DarioMSW/ESP32_Board/Hardware/v1.0/ESP32S3_DevBoard.brd

## EAGLE design Hardware/v1.0/ESP32S3_DevBoard.brd (2025-02-07)

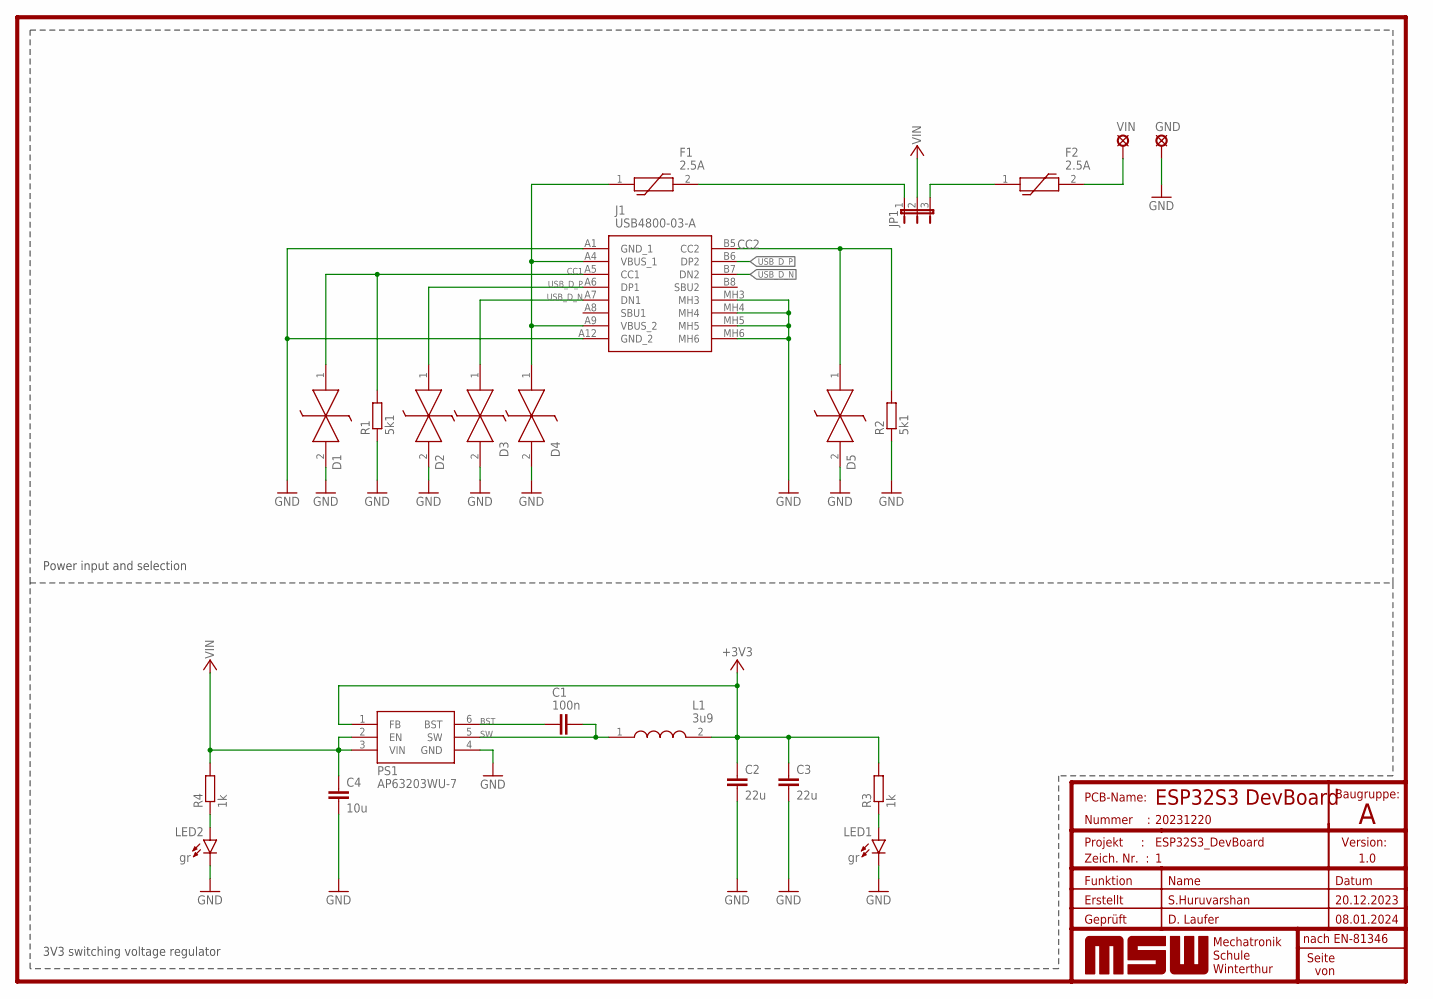
[picture p1: schematic ESP32S3_DevBoard.sch, sheet 1]

Parts:
C1: 100n; C0805
C2, C3: 22u; C1206
C4: 10u; C1206
D1, D2, D3, D4, D5: GG060305100N2P; DIONC1608X70N
F1, F2: 2.5A; 2920L030DR
GND: LSP10
J1: USB4800-03-A; USB480003A
JP1: JP2W
L1: 3u9; 74404052039
LED1, LED2: gr; CHIPLED_1206
PS1: AP63203WU-7; SOT95P280X100-6N
R1, R2: 5k1; R0805
R3, R4: 1k; R0805
VIN: LSP10

Connections:
+3V3: C2.1, C3.1, L1.2, PS1.1 (FB), R3.2; also elsewhere on the board
BST: C1.1, PS1.6 (BST)
CC1: D1.1 (K1), J1.A5 (CC1), R1.2
CC2: D5.1 (K1), J1.B5 (CC2), R2.2
GND: C2.2, C3.2, C4.2, D1.2 (K2), D2.2 (K2), D3.2 (K2), D4.2 (K2), D5.2 (K2), GND.MP, J1.A1 (GND_1), J1.A12 (GND_2), J1.MH3, J1.MH4, J1.MH5, J1.MH6, LED1.C, LED2.C, PS1.4 (GND), R1.1, R2.1; also elsewhere on the board
unnamed: F2.2, VIN.MP
unnamed: LED2.A, R4.1
unnamed: LED1.A, R3.1
unnamed: F1.2, JP1.1
unnamed: F2.1, JP1.3
SW: C1.2, L1.1, PS1.5 (SW)
USB_D_N: D3.1 (K1), J1.A7 (DN1), J1.B7 (DN2); also elsewhere on the board
USB_D_P: D2.1 (K1), J1.A6 (DP1), J1.B6 (DP2); also elsewhere on the board
VFUSE: D4.1 (K1), F1.1, J1.A4 (VBUS_1), J1.A9 (VBUS_2)
VTERMINAL: C4.1, JP1.2, PS1.2 (EN), PS1.3 (VIN), R4.2; also elsewhere on the board

Notes on the sheet:
Power input and selection
3V3 switching voltage regulator

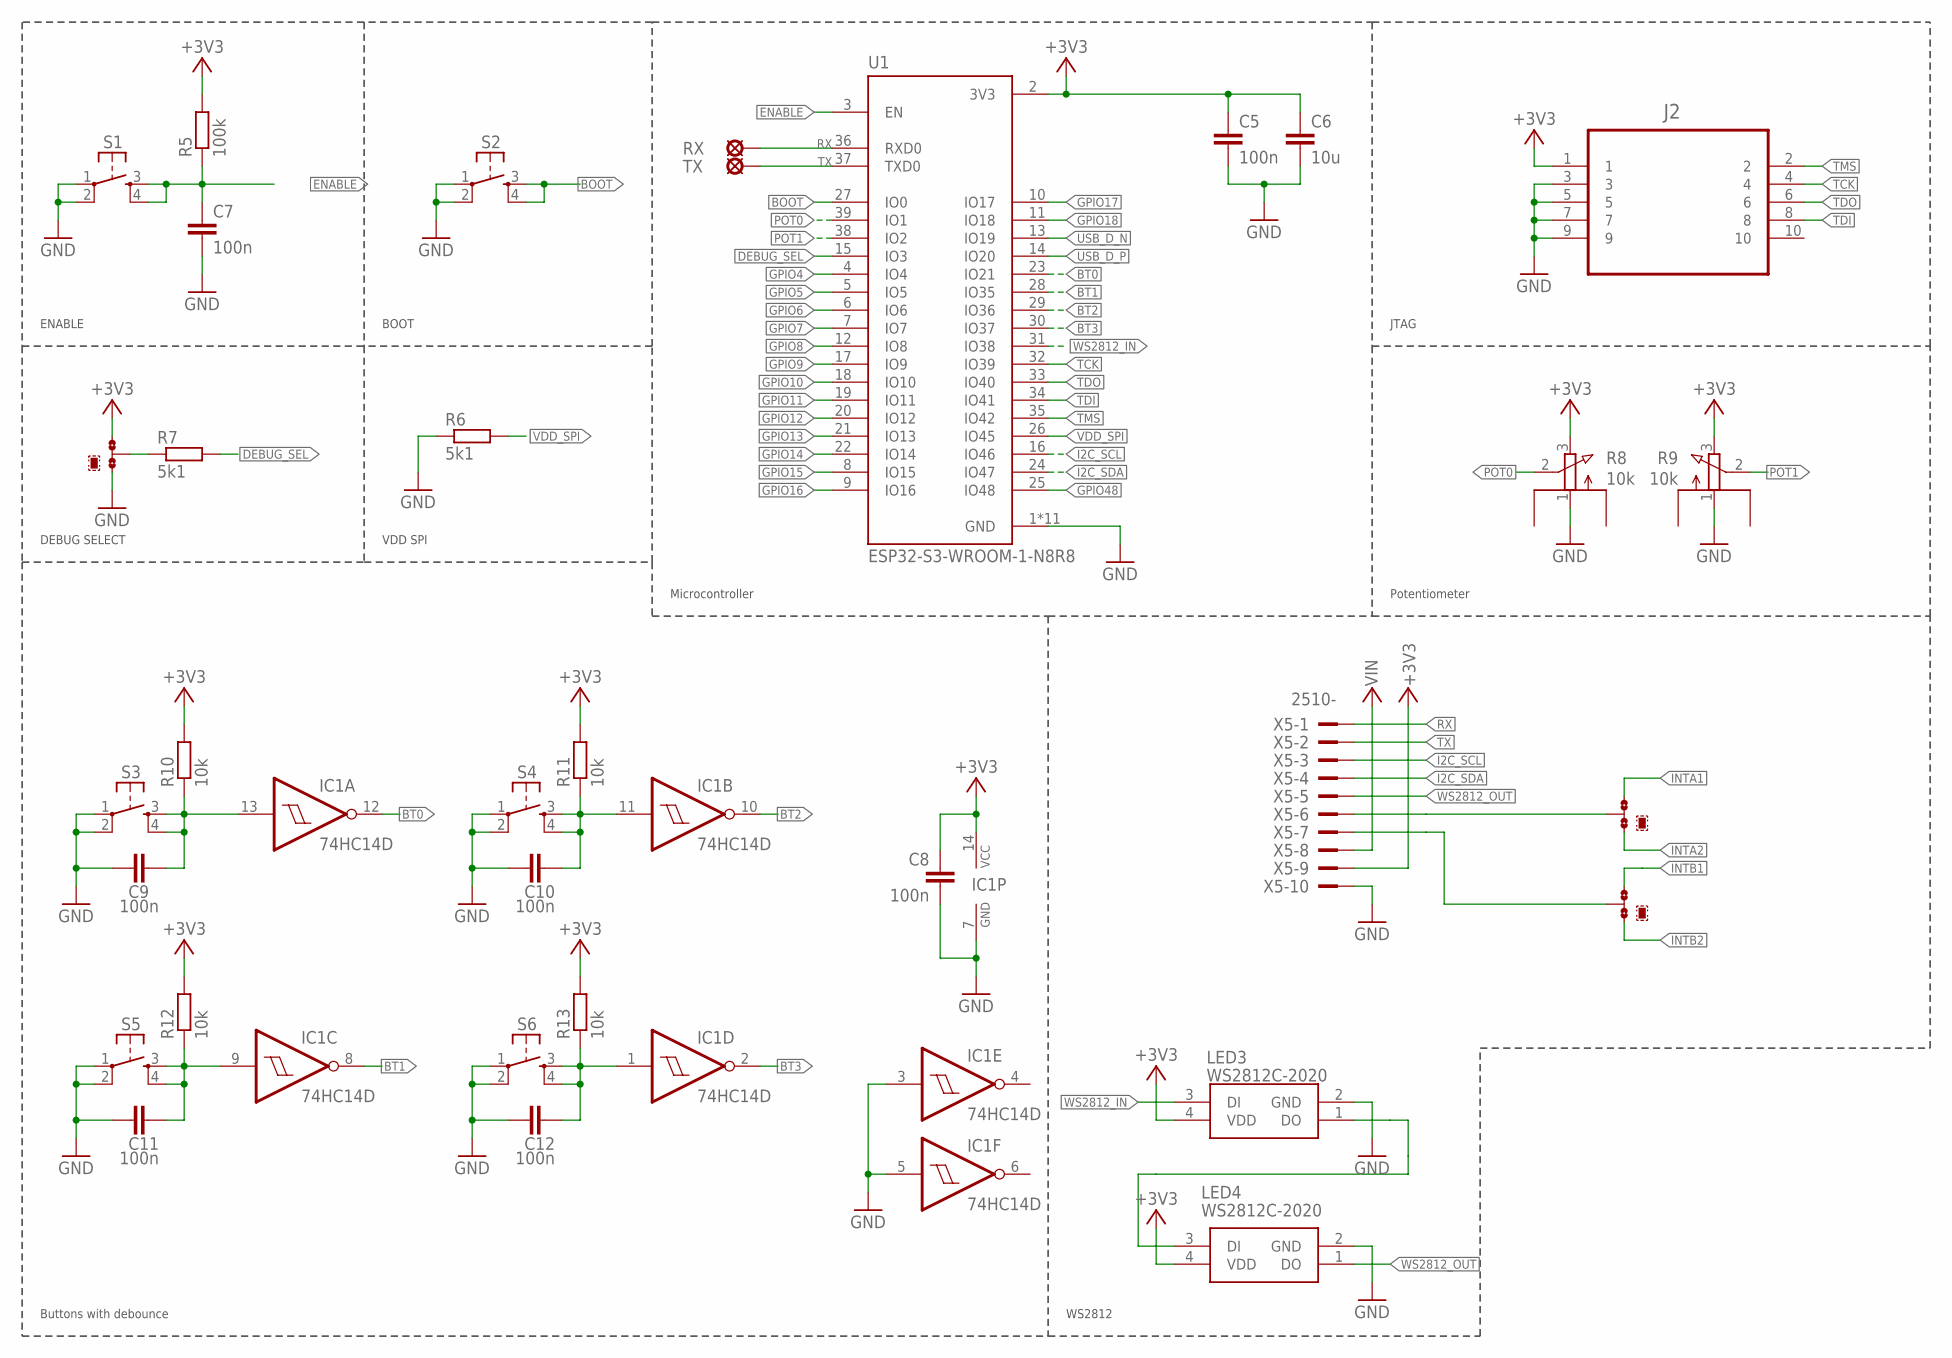
[picture p2: schematic ESP32S3_DevBoard.sch, sheet 2]

Parts:
C5, C7, C8, C9, C10, C11, C12: 100n; C0805
C6: 10u; C1206
IC1: 74HC14D; SO14
J2: 3220-10-0100-00; SAMTEC_FTS-105-01-L-D
JMP1, JMP2, JMP3: 0R-JUMPC; C0R-JMP
LED3, LED4: WS2812C-2020; WS2812C2020
R5: 100k; R0805
R6, R7: 5k1; R0805
R8, R9: 10k; EVUF
R10, R11, R12, R13: 10k; R0805
RX: LSP10
S1, S2, S3, S4, S5, S6: TS42_4PAD
TX: LSP10
U1: ESP32-S3-WROOM-1-N8R8; XCVR_ESP32S3WROOM1N8R8
X5: 2510-; PAK100/2500-10

Connections:
+3V3: C5.1, C6.1, C8.1, IC1.14 (VCC), J2.1, JMP1.1, LED3.4 (VDD), LED4.4 (VDD), R5.2, R8.3 (E), R9.3 (E), R10.2, R11.2, R12.2, R13.2, U1.2 (3V3), X5.9; also elsewhere on the board
BOOT: S2.3, S2.4, U1.27 (IO0)
BT0: IC1.12 (O), U1.23 (IO21)
BT1: IC1.8 (O), U1.28 (IO35)
BT2: IC1.10 (O), U1.29 (IO36)
BT3: IC1.2 (O), U1.30 (IO37)
DEBUG_SEL: R7.2, U1.15 (IO3)
ENABLE: C7.1, R5.1, S1.3, S1.4, U1.3 (EN)
GND: C5.2, C6.2, C7.2, C8.2, C9.2, C10.2, C11.2, C12.2, IC1.3 (I), IC1.5 (I), IC1.7 (GND), J2.3, J2.5, J2.7, J2.9, JMP1.3, LED3.2 (GND), LED4.2 (GND), R6.1, R8.1 (A), R9.1 (A), S1.1, S1.2, S2.1, S2.2, S3.1, S3.2, S4.1, S4.2, S5.1, S5.2, S6.1, S6.2, U1.1 (GND), U1.40 (GND), U1.41_1 (GND), U1.41_2 (GND), U1.41_3 (GND), U1.41_4 (GND), U1.41_5 (GND), U1.41_6 (GND), U1.41_7 (GND), U1.41_8 (GND), U1.41_9 (GND), X5.10; also elsewhere on the board
GPIO4: U1.4 (IO4); also elsewhere on the board
GPIO5: U1.5 (IO5); also elsewhere on the board
GPIO6: U1.6 (IO6); also elsewhere on the board
GPIO7: U1.7 (IO7); also elsewhere on the board
GPIO8: U1.12 (IO8); also elsewhere on the board
GPIO9: U1.17 (IO9); also elsewhere on the board
GPIO10: U1.18 (IO10); also elsewhere on the board
GPIO11: U1.19 (IO11); also elsewhere on the board
GPIO12: U1.20 (IO12); also elsewhere on the board
GPIO13: U1.21 (IO13); also elsewhere on the board
GPIO14: U1.22 (IO14); also elsewhere on the board
GPIO15: U1.8 (IO15); also elsewhere on the board
GPIO16: U1.9 (IO16); also elsewhere on the board
GPIO17: U1.10 (IO17); also elsewhere on the board
GPIO18: U1.11 (IO18); also elsewhere on the board
GPIO48: U1.25 (IO48); also elsewhere on the board
I2C_SCL: U1.16 (IO46), X5.3; also elsewhere on the board
I2C_SDA: U1.24 (IO47), X5.4; also elsewhere on the board
INTA1: JMP2.3; also elsewhere on the board
INTA2: JMP2.1; also elsewhere on the board
INTB1: JMP3.3; also elsewhere on the board
INTB2: JMP3.1; also elsewhere on the board
unnamed: JMP1.2, R7.1
unnamed: C9.1, IC1.13 (I), R10.1, S3.3, S3.4
unnamed: C11.1, IC1.9 (I), R12.1, S5.3, S5.4
unnamed: C10.1, IC1.11 (I), R11.1, S4.3, S4.4
unnamed: C12.1, IC1.1 (I), R13.1, S6.3, S6.4
unnamed: LED3.1 (DO), LED4.3 (DI)
unnamed: JMP2.2, X5.6
unnamed: JMP3.2, X5.7
POT0: R8.2 (S), U1.39 (IO1)
POT1: R9.2 (S), U1.38 (IO2)
RX: RX.MP, U1.36 (RXD0), X5.1
TCK: J2.4, U1.32 (IO39)
TDI: J2.8, U1.34 (IO41)
TDO: J2.6, U1.33 (IO40)
TMS: J2.2, U1.35 (IO42)
TX: TX.MP, U1.37 (TXD0), X5.2
USB_D_N: U1.13 (IO19); also elsewhere on the board
USB_D_P: U1.14 (IO20); also elsewhere on the board
VDD_SPI: R6.2, U1.26 (IO45)
VTERMINAL: X5.8; also elsewhere on the board
WS2812_IN: LED3.3 (DI), U1.31 (IO38)
WS2812_OUT: LED4.1 (DO), X5.5

Notes on the sheet:
ENABLE
DEBUG SELECT
BOOT
VDD SPI
Microcontroller
JTAG
Potentiometer
Buttons with debounce
WS2812

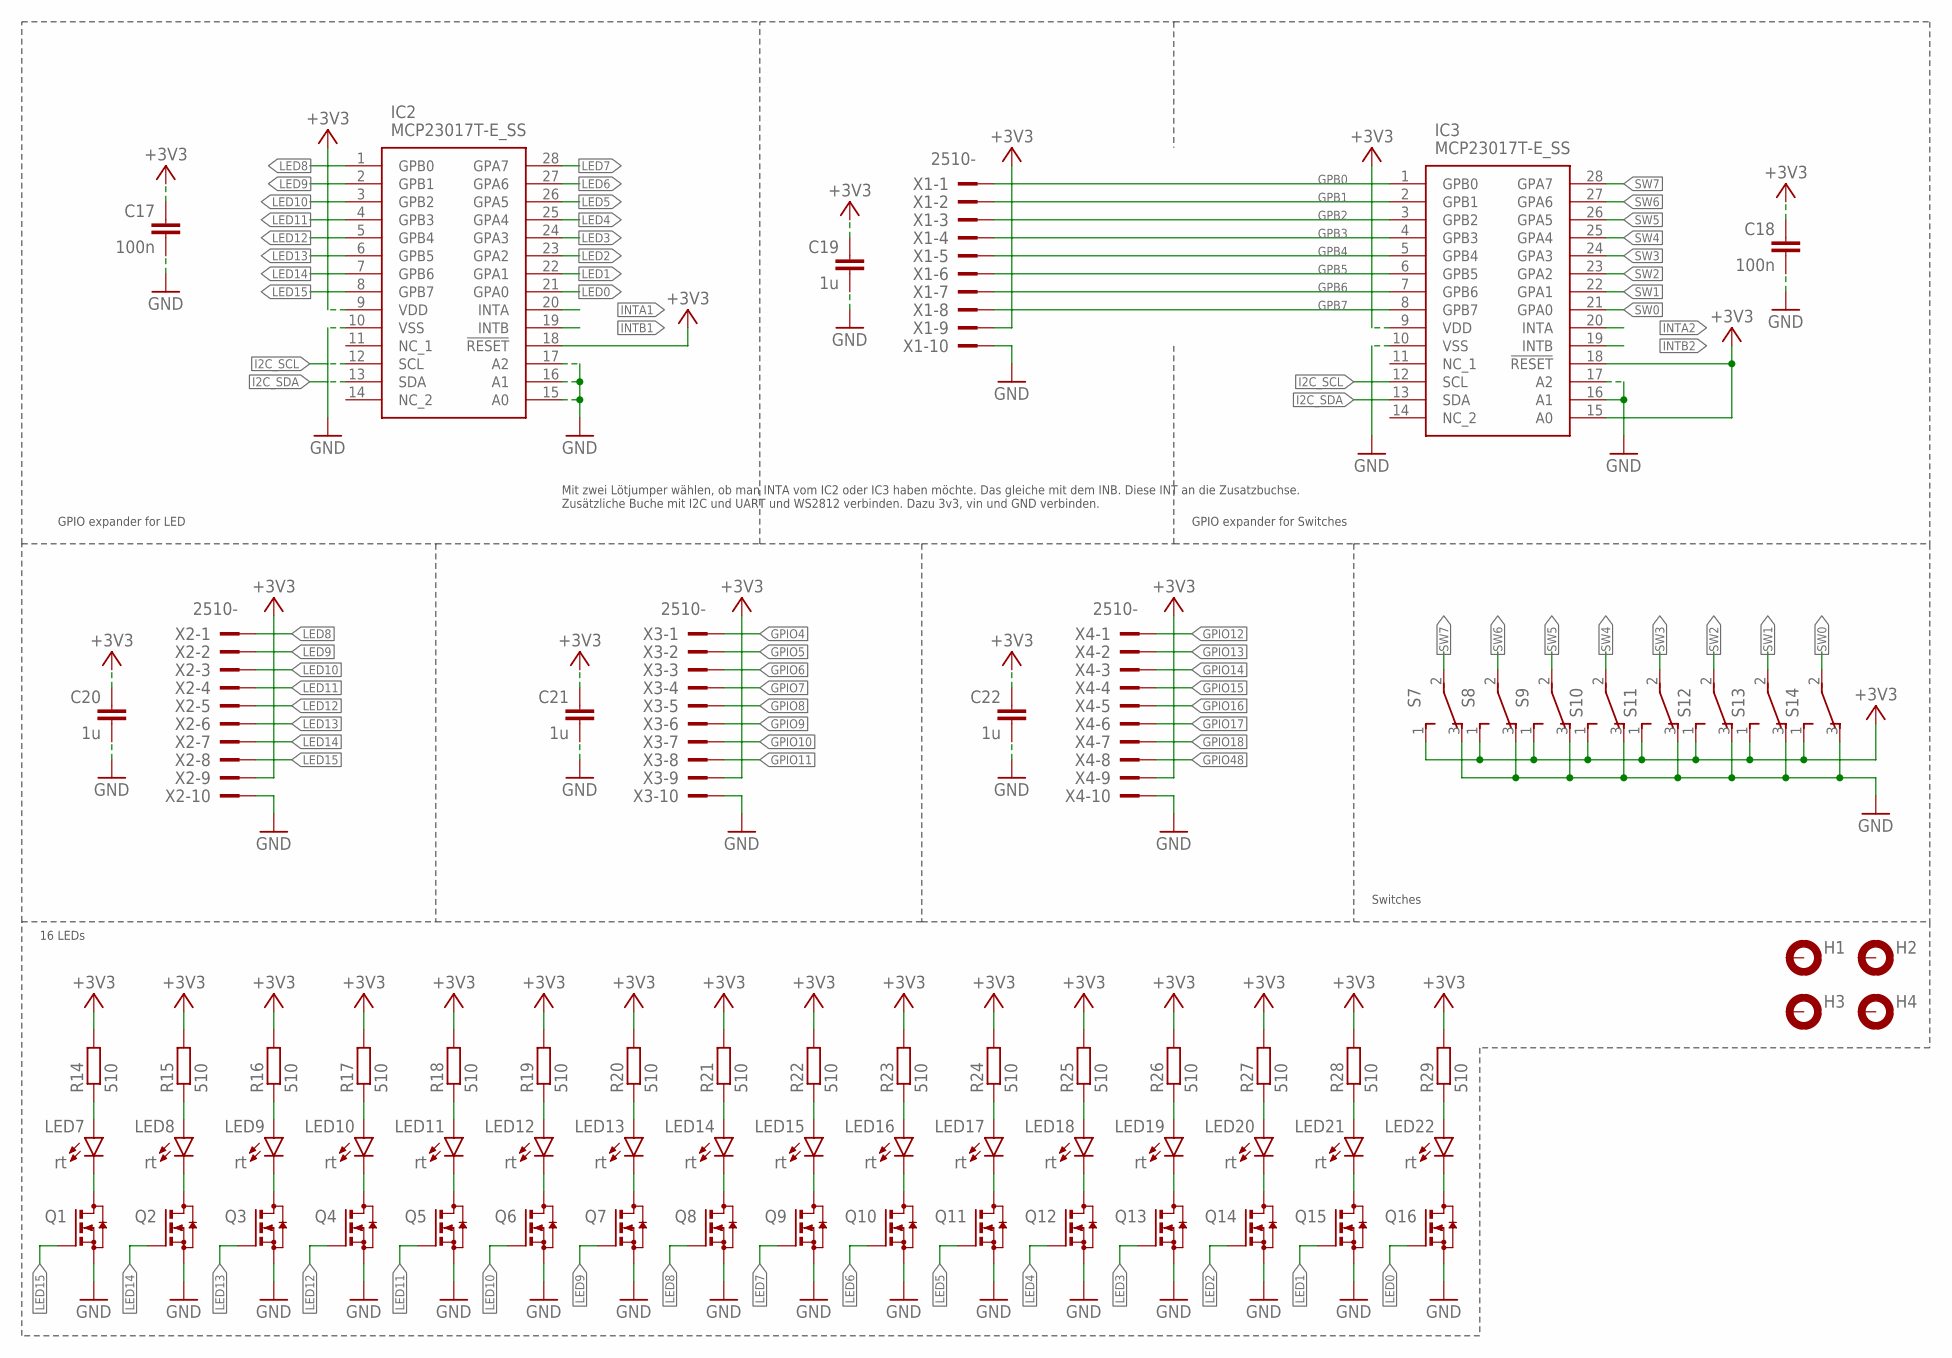
[picture p3: schematic ESP32S3_DevBoard.sch, sheet 3]

Parts:
C17, C18: 100n; C0805
C19, C20, C21, C22: 1u; C0805
H1, H2, H3, H4: MOUNT-PAD-ROUND3.3; 3,3-PAD
IC2, IC3: MCP23017T-E_SS; SOP65P780X200-28N
LED7, LED8, LED9, LED10, LED11, LED12, LED13, LED14, LED15, LED16, LED17, LED18, LED19, LED20, LED21, LED22: rt; CHIPLED_1206
Q1, Q2, Q3, Q4, Q5, Q6, Q7, Q8, Q9, Q10, Q11, Q12, Q13, Q14, Q15, Q16: PMV20EN; SOT23
R14, R15, R16, R17, R18, R19, R20, R21, R22, R23, R24, R25, R26, R27, R28, R29: 510; R0805
S7, S8, S9, S10, S11, S12, S13, S14: TL36POSPDT_5MM; SPDT_5MM
X1, X2, X3, X4: 2510-; PAK100/2500-10

Connections:
+3V3: C17.1, C18.1, C19.1, C20.1, C21.1, C22.1, IC2.9 (VDD), IC2.18 (!RESET), IC3.9 (VDD), IC3.15 (A0), IC3.18 (!RESET), R14.2, R15.2, R16.2, R17.2, R18.2, R19.2, R20.2, R21.2, R22.2, R23.2, R24.2, R25.2, R26.2, R27.2, R28.2, R29.2, S7.1 (S), S8.1 (S), S9.1 (S), S10.1 (S), S11.1 (S), S12.1 (S), S13.1 (S), S14.1 (S), X1.9, X2.9, X3.9, X4.9; also elsewhere on the board
GND: C17.2, C18.2, C19.2, C20.2, C21.2, C22.2, IC2.10 (VSS), IC2.15 (A0), IC2.16 (A1), IC2.17 (A2), IC3.10 (VSS), IC3.16 (A1), IC3.17 (A2), Q1.2 (S), Q2.2 (S), Q3.2 (S), Q4.2 (S), Q5.2 (S), Q6.2 (S), Q7.2 (S), Q8.2 (S), Q9.2 (S), Q10.2 (S), Q11.2 (S), Q12.2 (S), Q13.2 (S), Q14.2 (S), Q15.2 (S), Q16.2 (S), S7.3 (O), S8.3 (O), S9.3 (O), S10.3 (O), S11.3 (O), S12.3 (O), S13.3 (O), S14.3 (O), X1.10, X2.10, X3.10, X4.10; also elsewhere on the board
GPB0: IC3.1 (GPB0), X1.1
GPB1: IC3.2 (GPB1), X1.2
GPB2: IC3.3 (GPB2), X1.3
GPB3: IC3.4 (GPB3), X1.4
GPB4: IC3.5 (GPB4), X1.5
GPB5: IC3.6 (GPB5), X1.6
GPB6: IC3.7 (GPB6), X1.7
GPB7: IC3.8 (GPB7), X1.8
GPIO4: X3.1; also elsewhere on the board
GPIO5: X3.2; also elsewhere on the board
GPIO6: X3.3; also elsewhere on the board
GPIO7: X3.4; also elsewhere on the board
GPIO8: X3.5; also elsewhere on the board
GPIO9: X3.6; also elsewhere on the board
GPIO10: X3.7; also elsewhere on the board
GPIO11: X3.8; also elsewhere on the board
GPIO12: X4.1; also elsewhere on the board
GPIO13: X4.2; also elsewhere on the board
GPIO14: X4.3; also elsewhere on the board
GPIO15: X4.4; also elsewhere on the board
GPIO16: X4.5; also elsewhere on the board
GPIO17: X4.6; also elsewhere on the board
GPIO18: X4.7; also elsewhere on the board
GPIO48: X4.8; also elsewhere on the board
I2C_SCL: IC2.12 (SCL), IC3.12 (SCL); also elsewhere on the board
I2C_SDA: IC2.13 (SDA), IC3.13 (SDA); also elsewhere on the board
INTA1: IC2.20 (INTA); also elsewhere on the board
INTA2: IC3.20 (INTA); also elsewhere on the board
INTB1: IC2.19 (INTB); also elsewhere on the board
INTB2: IC3.19 (INTB); also elsewhere on the board
LED0: IC2.21 (GPA0), Q16.1 (G)
LED1: IC2.22 (GPA1), Q15.1 (G)
LED2: IC2.23 (GPA2), Q14.1 (G)
LED3: IC2.24 (GPA3), Q13.1 (G)
LED4: IC2.25 (GPA4), Q12.1 (G)
LED5: IC2.26 (GPA5), Q11.1 (G)
LED6: IC2.27 (GPA6), Q10.1 (G)
LED7: IC2.28 (GPA7), Q9.1 (G)
LED8: IC2.1 (GPB0), Q8.1 (G), X2.1
LED9: IC2.2 (GPB1), Q7.1 (G), X2.2
LED10: IC2.3 (GPB2), Q6.1 (G), X2.3
LED11: IC2.4 (GPB3), Q5.1 (G), X2.4
LED12: IC2.5 (GPB4), Q4.1 (G), X2.5
LED13: IC2.6 (GPB5), Q3.1 (G), X2.6
LED14: IC2.7 (GPB6), Q2.1 (G), X2.7
LED15: IC2.8 (GPB7), Q1.1 (G), X2.8
unnamed: LED14.C, Q8.3 (D)
unnamed: LED14.A, R21.1
unnamed: LED15.C, Q9.3 (D)
unnamed: LED15.A, R22.1
unnamed: LED16.C, Q10.3 (D)
unnamed: LED16.A, R23.1
unnamed: LED17.C, Q11.3 (D)
unnamed: LED17.A, R24.1
unnamed: LED18.C, Q12.3 (D)
unnamed: LED18.A, R25.1
unnamed: LED19.C, Q13.3 (D)
unnamed: LED19.A, R26.1
unnamed: LED20.C, Q14.3 (D)
unnamed: LED20.A, R27.1
unnamed: LED21.C, Q15.3 (D)
unnamed: LED21.A, R28.1
unnamed: LED22.C, Q16.3 (D)
unnamed: LED22.A, R29.1
unnamed: LED13.C, Q7.3 (D)
unnamed: LED13.A, R20.1
unnamed: LED12.C, Q6.3 (D)
unnamed: LED12.A, R19.1
unnamed: LED11.C, Q5.3 (D)
unnamed: LED11.A, R18.1
unnamed: LED10.C, Q4.3 (D)
unnamed: LED10.A, R17.1
unnamed: LED9.C, Q3.3 (D)
unnamed: LED9.A, R16.1
unnamed: LED8.C, Q2.3 (D)
unnamed: LED8.A, R15.1
unnamed: LED7.C, Q1.3 (D)
unnamed: LED7.A, R14.1
SW0: IC3.21 (GPA0), S14.2
SW1: IC3.22 (GPA1), S13.2
SW2: IC3.23 (GPA2), S12.2
SW3: IC3.24 (GPA3), S11.2
SW4: IC3.25 (GPA4), S10.2
SW5: IC3.26 (GPA5), S9.2
SW6: IC3.27 (GPA6), S8.2
SW7: IC3.28 (GPA7), S7.2

Notes on the sheet:
GPIO expander for LED
GPIO expander for Switches
Switches
16 LEDs
Mit zwei Lötjumper wählen, ob man INTA vom IC2 oder IC3 haben möchte. Das gleiche mit dem INB. Diese INT an die Zusatzbuchse. Zusätzliche Buche mit I2C und UART und WS2812 verbinden. Dazu 3v3, vin und GND verbinden.

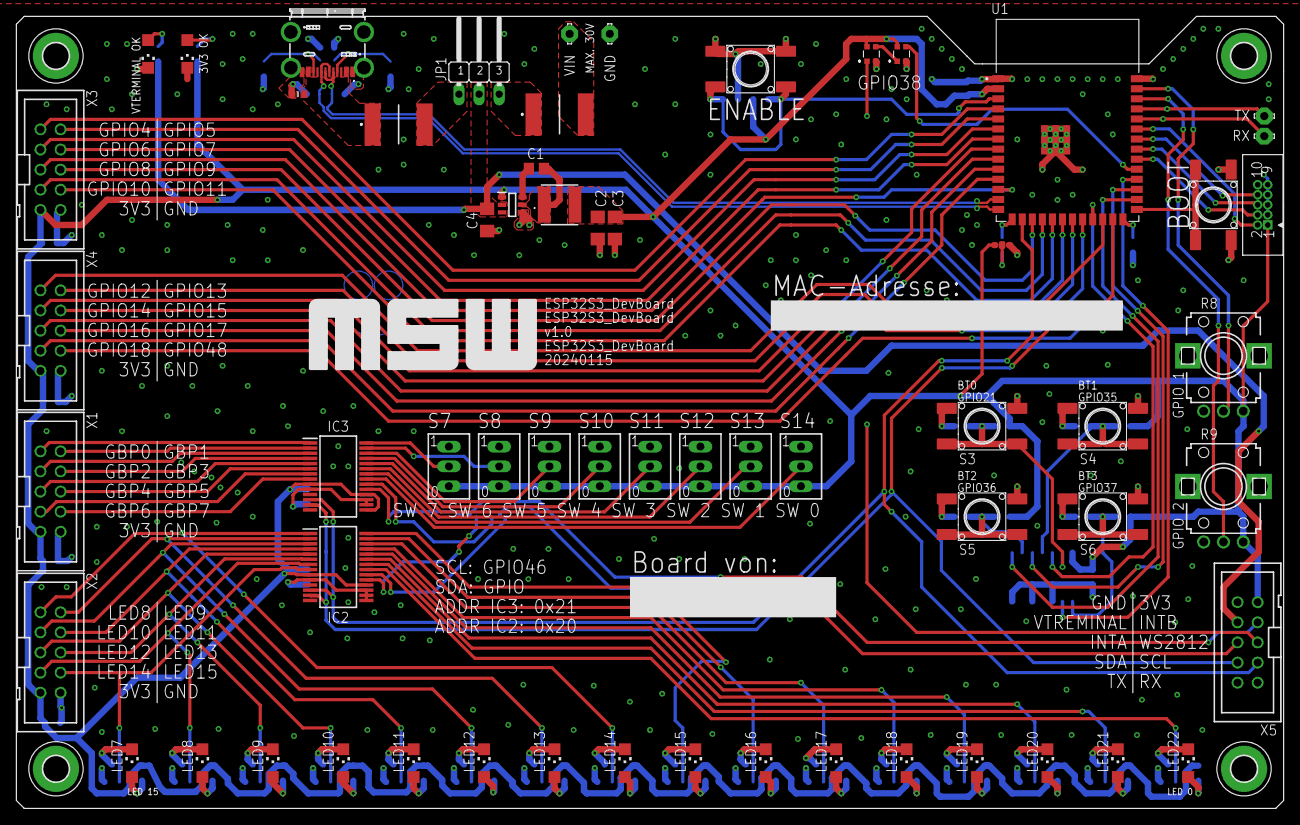
[picture p4: board ESP32S3_DevBoard.brd from above]

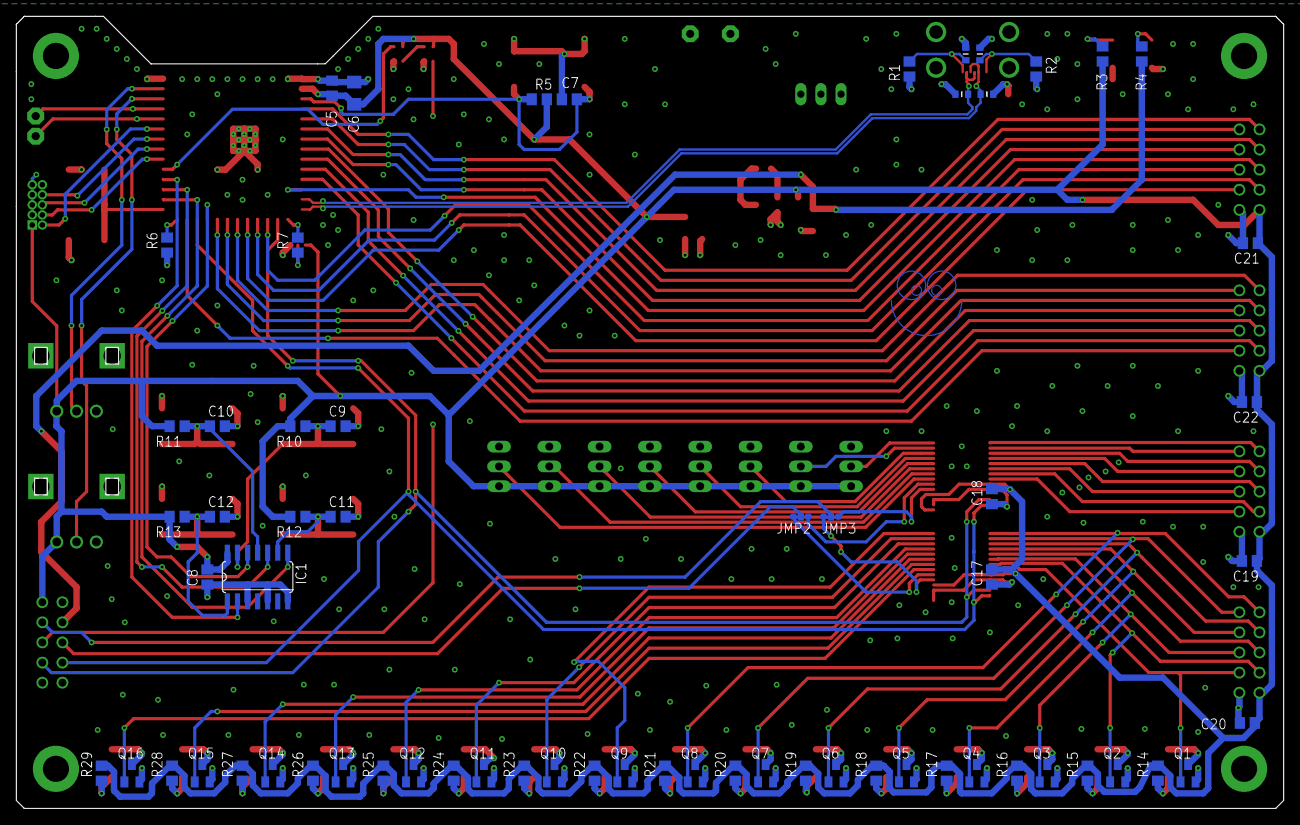
[picture p5: board ESP32S3_DevBoard.brd from below]

Board: 4 copper layers, 160.0 x 100.0 mm, 131 parts (64 on the bottom side), 127 nets.

Other parts of the board:
U$1: PCB_BESCHRIFTUNG
U$5: PCB_LOGO_3_28MM5
