DarioMSW/ESP32_Board/(commit log)

2025-01-31 Before New Driver
2025-01-31 New I2C-Driver
    Made with DeepSeek AI
2025-02-07 Schematic, Layout and Gerber added
    [ESP32S3_DevBoard.brd, ESP32S3_DevBoard.sch]
2026-02-05 Funktionierendes Beispiel ESP-Board
